LeemanGeophysicalLLC/SkyGuard_Cutdown_Pro_Electronics/README.md

# SkyGuard_Cutdown_Pro
SkyGuard Cutdown Pro high altitude balloon flight termination device
