LeemanGeophysicalLLC/SkyGuard_Cutdown_Pro_Electronics/Renders/pcb_back.png

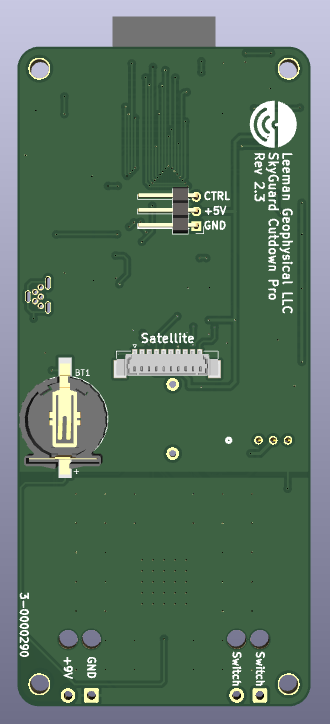
Renders/pcb_back.png
