LeemanGeophysicalLLC/SkyGuard_Cutdown_Pro_Electronics/Renders/pcb_front.png

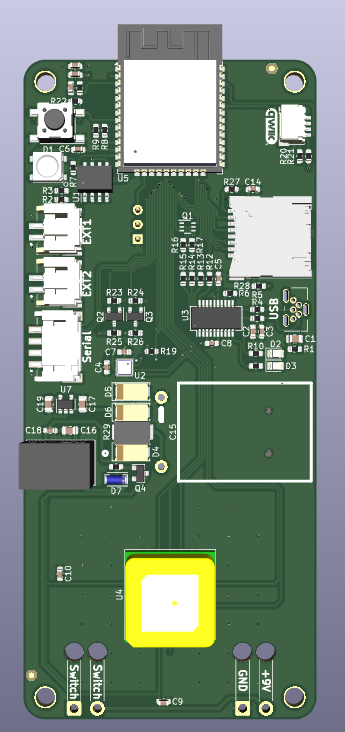
Renders/pcb_front.png
