LeemanGeophysicalLLC/SkyGuard_Cutdown_Pro_Electronics/PDFs/schematic.pdf

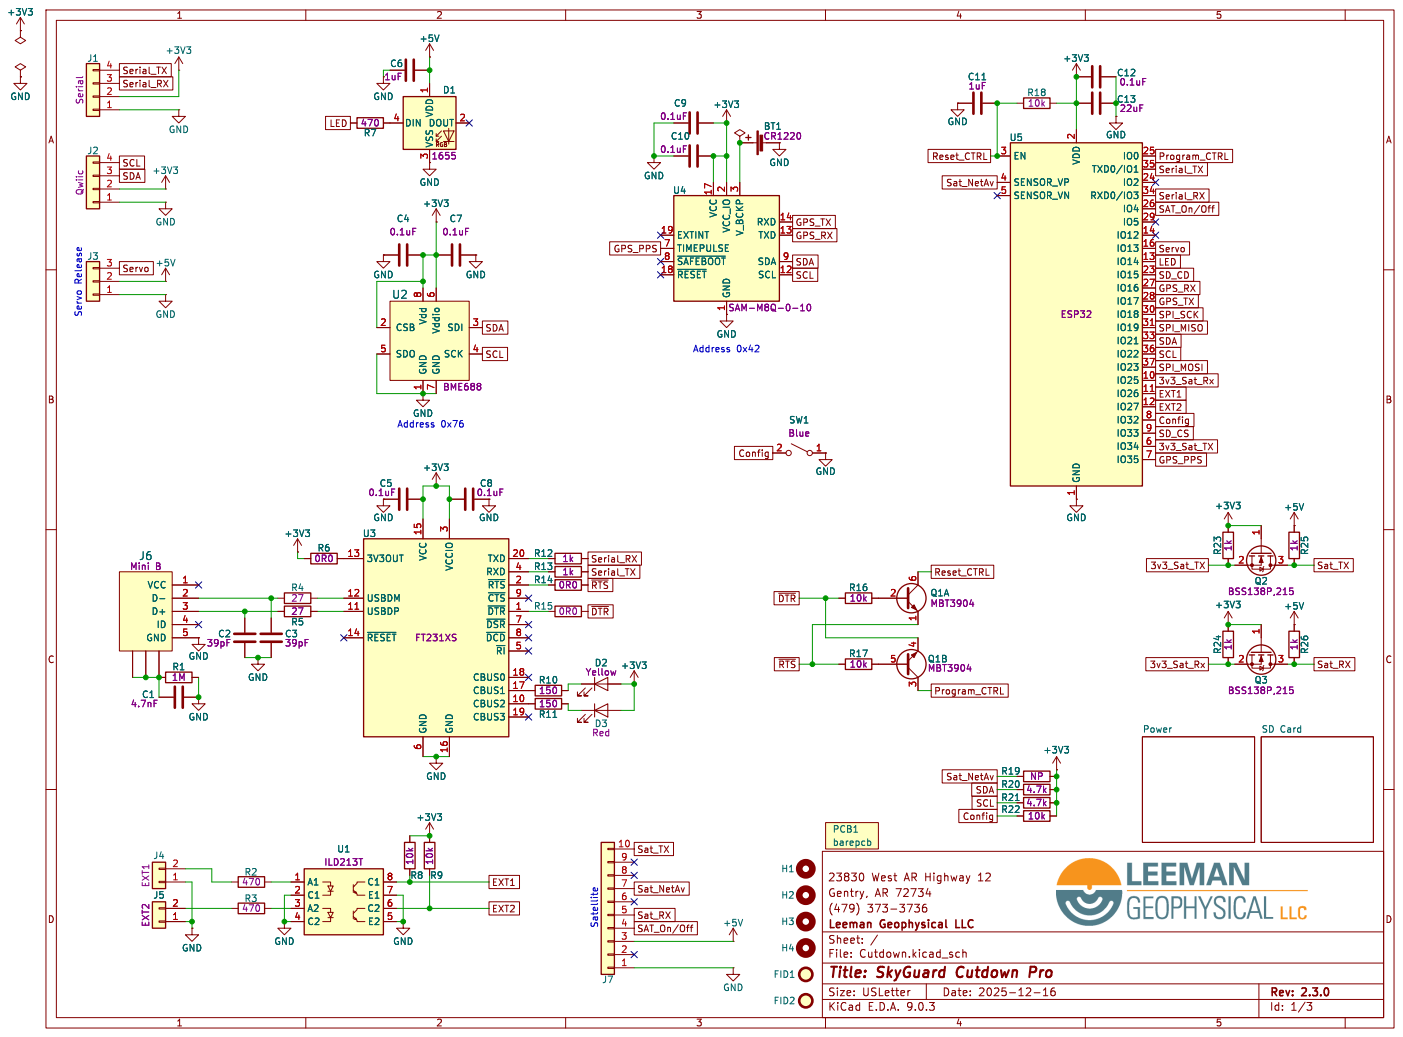
[picture p3: page 1]

3 RXD 14 TXD 13 SDA 9 SCL 12 C9

3 RXD 14 TXD 13 SDA 9 SCL 12 U4 SAM-M8Q-0-10

3 GND 16 TXD 20 RXD 4 ~{RTS}2 ~{CTS}9 ~{DTR}1 ~{DSR}7 ~{DCD}8 ~{RI}5 CBUS0 18 CBUS1 17 CBUS2 10 CBUS3 19 U3 FT231XS GND GND

3 GND 16 TXD 20 RXD 4 ~{RTS}2 ~{CTS}9 ~{DTR}1 ~{DSR}7 ~{DCD}8 ~{RI}5 CBUS0 18 CBUS1 17 CBUS2 10 CBUS3 19 R13 1k R14 0R0 R12 1k +3V3 GND

Id: 1/3 Title: SkyGuard Cutdown Pro

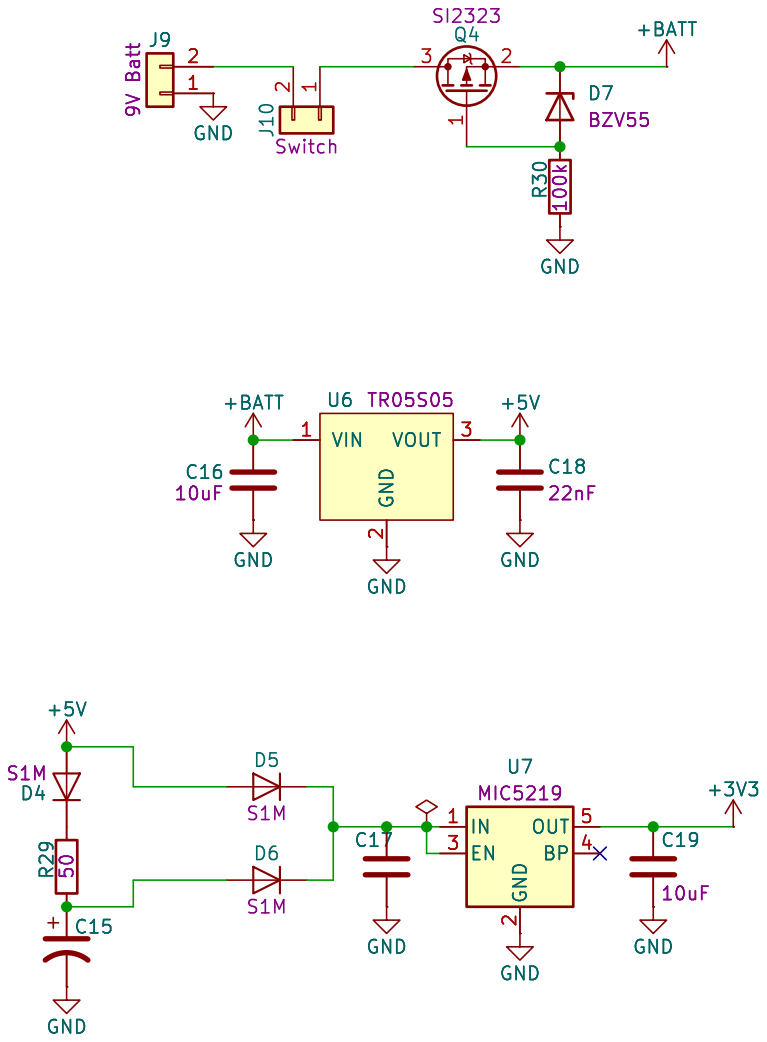
[picture p4: page 2]

Id: 3/3 Title: SkyGuard Cutdown Pro

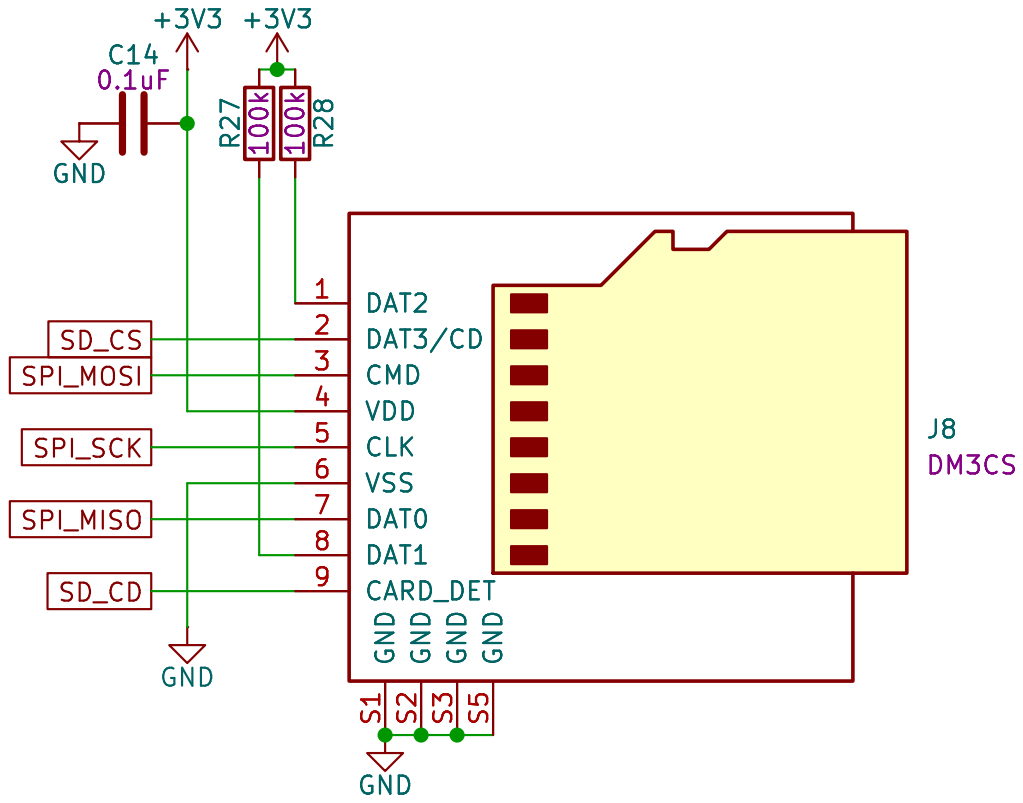
[picture p5: page 3]

Id: 2/3 Title: SkyGuard Cutdown Pro
