LeemanGeophysicalLLC/SkyGuard_Cutdown_Pro_Electronics/PDFs/pcb.pdf

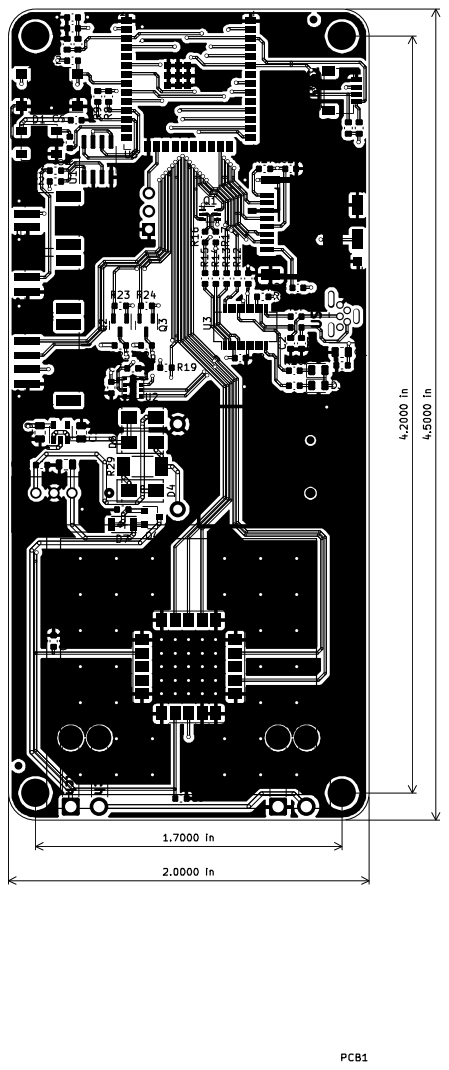
[picture p6: page 1]
