LeemanGeophysicalLLC/SkyGuard_Cutdown_Pro_Electronics/(threads)

Thread 5 (2024-06-24):

Change voltage provided on UART connector

jrleeman, 2024-06-24:
Since UART pins are not 5V tolerant, lets go ahead and swap the power on the UART connector for 3V3. I doubt many will use it, but its there if they want to.

Closed 2024-11-07.
