LeemanGeophysicalLLC/SkyGuard_Cutdown_Pro_Electronics/(commit log)

2024-01-31 First revision PCB
    [Cutdown-B_Cu.gbr, Cutdown-B_Mask.gbr, Cutdown-B_Paste.gbr, Cutdown-B_Silkscreen.gbr, Cutdown-Edge_Cuts.gbr, Cutdown-F_Cu.gbr, Cutdown-F_Mask.gbr, Cutdown-F_Paste.gbr]
2024-02-20 Enlarged switch wire holes
    [Cutdown.kicad_pcb, Cutdown.kicad_sch]
2024-02-20 Removed EXT3&4, Switch isolator to ILD213T
    [Cutdown.kicad_pcb, Cutdown.kicad_sch]
2024-02-20 Switch JST pinouts to match adafruit standard
    [Cutdown.kicad_pcb, Cutdown.kicad_sch]
2024-02-20 Relocated U6, Added Second Supercap
    [Cutdown.kicad_pcb, Cutdown.kicad_sch]
2024-02-20 Isolated JST Grounds
    [Cutdown.kicad_pcb, Cutdown.kicad_sch]
2024-02-20 Added 4pin JST Serial Connector
    [Cutdown.kicad_pcb, Cutdown.kicad_sch]
2024-02-20 Removed Rx/Tx Jumpers, Added Quick Connector
    [Cutdown.kicad_pcb, Cutdown.kicad_sch]
2024-02-20 Silkscreen/ERC error corrections
    [Cutdown.kicad_pcb, Cutdown.kicad_sch]
2024-02-21 Updated Version/Intern Part Number
    [Cutdown.kicad_pcb, Cutdown.kicad_sch]
2024-06-07 Removed all hotwire electronics, Added Servo connection, Relayout for PCB Shape, Updated revisions to 2.0
    [Cutdown.kicad_pcb, Cutdown.kicad_sch]
2024-06-07 Fixed Servo Pinout
    [Cutdown.kicad_pcb, Cutdown.kicad_sch]
2024-06-07 Fixed EXT1&2 Pinouts
    [Cutdown.kicad_pcb, Cutdown.kicad_sch]
2024-06-07 production files
    [Cutdown-B_Cu.gbr, Cutdown-B_Mask.gbr, Cutdown-B_Paste.gbr, Cutdown-B_Silkscreen.gbr, Cutdown-Edge_Cuts.gbr, Cutdown-F_Cu.gbr, Cutdown-F_Mask.gbr, Cutdown-F_Paste.gbr]
2024-06-07 Moved Pico up so USB is accessable
    [Cutdown.kicad_pcb, Cutdown.kicad_sch]
2024-06-07 Move part and remake production files
    [Cutdown-B_Cu.gbr, Cutdown-B_Mask.gbr, Cutdown-B_Paste.gbr, Cutdown-B_Silkscreen.gbr, Cutdown-Edge_Cuts.gbr, Cutdown-F_Cu.gbr, Cutdown-F_Mask.gbr, Cutdown-F_Paste.gbr]
2024-06-27 Fixed Issue#4 Changed R4 & R5 to a 470ohm Resistor
    [Cutdown.kicad_pcb, Cutdown.kicad_sch]
2024-06-27 Fixed Issue #5 Changed Serial power to 3v3 from 5v
    [Cutdown.kicad_pcb, Cutdown.kicad_sch]
2024-11-06 3 Modifications: Added Satellite Modem Connector Moved Servo Connector to Back Side Add 3rd EXT connected w/o an optoisolator
    [Cutdown.kicad_pcb, Cutdown.kicad_sch]
2024-11-06 Updated PCB/Rev Numbers
    [Cutdown.kicad_pcb, Cutdown.kicad_sch]
2024-11-06 Updated Rev# on SilkScreen
    [Cutdown.kicad_pcb]
2024-11-07 Replaced Obsoleted 1-1467 with New 1-1649
    [Cutdown.kicad_pcb, Cutdown.kicad_sch]
2024-11-07 Generate Rev 2.1 production files
    [Cutdown-B_Cu.gbr, Cutdown-B_Mask.gbr, Cutdown-B_Paste.gbr, Cutdown-B_Silkscreen.gbr, Cutdown-Edge_Cuts.gbr, Cutdown-F_Cu.gbr, Cutdown-F_Mask.gbr, Cutdown-F_Paste.gbr]
2024-11-07 Added SD Card
    [Cutdown.kicad_pcb, Cutdown.kicad_sch, sd_card.kicad_sch]
2024-11-11 Added Pullup to SD CD
    [Cutdown.kicad_pcb, Cutdown.kicad_sch]
2024-11-13 Make production files
    [Cutdown-B_Cu.gbr, Cutdown-B_Mask.gbr, Cutdown-B_Paste.gbr, Cutdown-B_Silkscreen.gbr, Cutdown-Edge_Cuts.gbr, Cutdown-F_Cu.gbr, Cutdown-F_Mask.gbr, Cutdown-F_Paste.gbr]
2025-09-30 Rev2.2 Changes (Shematic Initial Draft): - Swapped to ESP32 - Added USB with programming functionality - Connected GPS to I2C - Connected Satellite On/Off pin to GPIO
    [Cutdown.kicad_sch, power.kicad_sch, sd_card.kicad_sch]
2025-09-30 Finished Revised 2.2 Layout
    [Cutdown.kicad_pcb, Cutdown.kicad_sch, power.kicad_sch, sd_card.kicad_sch]
2025-10-13 Revisions: - Moved chip blocking EXT Connector - Rotated qwiic connector to avoid wires over the SD - Reworked GPS for recommended Layout - Addressed All ERC/DRC Issues
    [Cutdown.kicad_pcb, Cutdown.kicad_sch, power.kicad_sch, sd_card.kicad_sch]
2025-10-13 Added KiCAD Raw BOM
    [Cutdown.kicad_sch, KiCAD_raw_BOM.csv, power.kicad_sch, sd_card.kicad_sch]
2025-10-21 Make Rev 2.2 production files
    [Cutdown-B_Cu.gbr, Cutdown-B_Mask.gbr, Cutdown-B_Paste.gbr, Cutdown-B_Silkscreen.gbr, Cutdown-Edge_Cuts.gbr, Cutdown-F_Cu.gbr, Cutdown-F_Mask.gbr, Cutdown-F_Paste.gbr]
2025-12-16 Rev2.3: - Issue#9 (Removed Prog Header) - Issue#10 (Added Schematic I2C Addresses) - Issue#11 (Reversed FTDI Chip Serial Inputs) - Issue#12 (Removed GPS Serial Jumpers) - Issue#13 (Reversed GPS Seria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
    [Cutdown.kicad_pcb, Cutdown.kicad_sch, power.kicad_sch, sd_card.kicad_sch]
2025-12-17 Make Rev 2.3 production files
    [Cutdown-B_Cu.gbr, Cutdown-B_Mask.gbr, Cutdown-B_Paste.gbr, Cutdown-B_Silkscreen.gbr, Cutdown-Edge_Cuts.gbr, Cutdown-F_Cu.gbr, Cutdown-F_Mask.gbr, Cutdown-F_Paste.gbr]
